gurjarpravin4/Sorting_Mechanism/README.md

# Sorting_Mechanism
Color and Weight Based Package Sorting Mechanism.
This repository includes all the Schematics, PCB Layouts and Code we used to run this project.
It also includes a project report where the details of the project and it's results are discussed.
