gurjarpravin4/Sorting_Mechanism/Documentation/MiniProjectMain.pptx

## Pune Institute of Computer Technology, Pune Dept. of E&TC

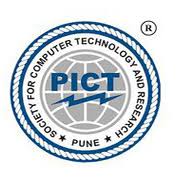
[picture p1: figure]

304200: Mini Project (MP)
(2019 Course)

“Colour and Weight Based
Sorting Model”

Guided By: Prof. Vaibhav Vaijapurkar

By:
1) Omkar Navalgundkar (32128)
2) Prajwal Padwal (32133)
3) Pravin Gurjar (32139)

## Introduction

- Wide use of sorting mechanisms in industries.
  - Recycling plants: They sort materials based on types, size and weight.
  - Manufacturing industries: They sort products based on defects or quality control criteria and ensure good product delivery.
- The proposed project is inspired by these different sorting mechanisms.
- Contribute to industries like toys industries, food and beverages processing industries etc.
- Will feature sorting based on parameters:
  - Colour
  - Weight

TE 5

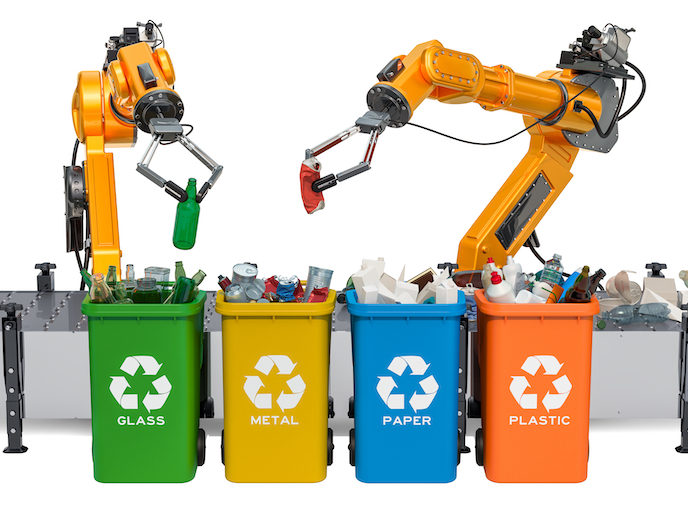
[picture p2: figure]

## Aim and Objectives

Aim:
- To design a sorting mechanism to sort objects based on colour and weight.
Objectives:
1. To study existing sorting techniques.
2. To develop a conveyor belt for the model using various motors.
3. To implement and verify the designed sorting system.

TE 5

## Block Schematic

Sorting Mechanism

Object Detection

Colour Sensor

Power Supply

Motor Driver for flaps

Motor Driver

Flaps

Microcontroller

Conveyor System

DC Motor

Weight Sensor

## Resources Required

1. ATMega 32
2. Permanent Magnet Stepper Motor
3. Conveyor Belt
4. DC motor
5. Colour sensor
6. IR sensor
7. Load cell
8. Soldering Gun and Solder

1. AVR Studio
2. Proteus Design Suite 8.0
3. AutoCAD

- Hardware

- Software

## Slide 6

Simulation Labels

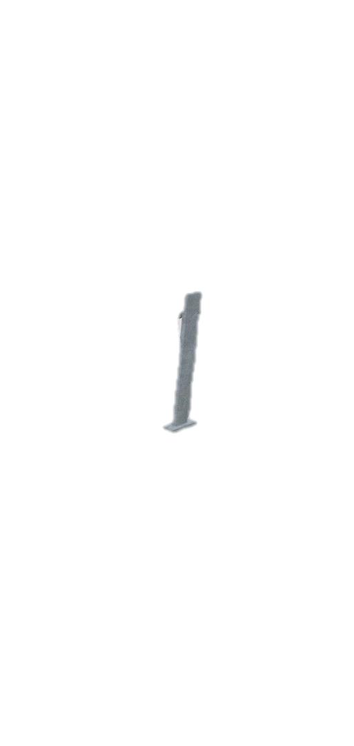
[picture p3: figure]
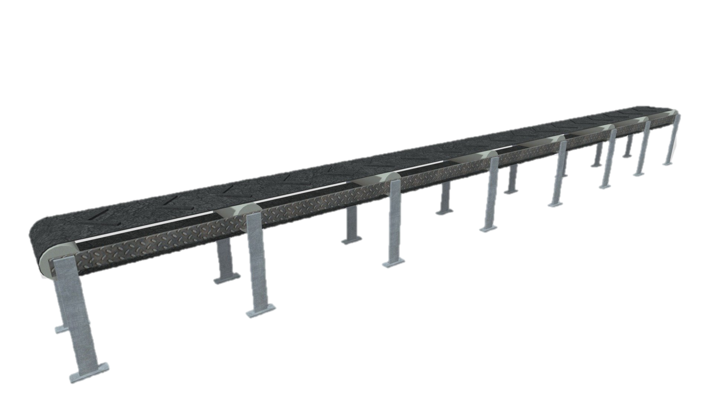
[picture p4: figure]

Flaps

Color sensor

IR sensor

Stepper Motor

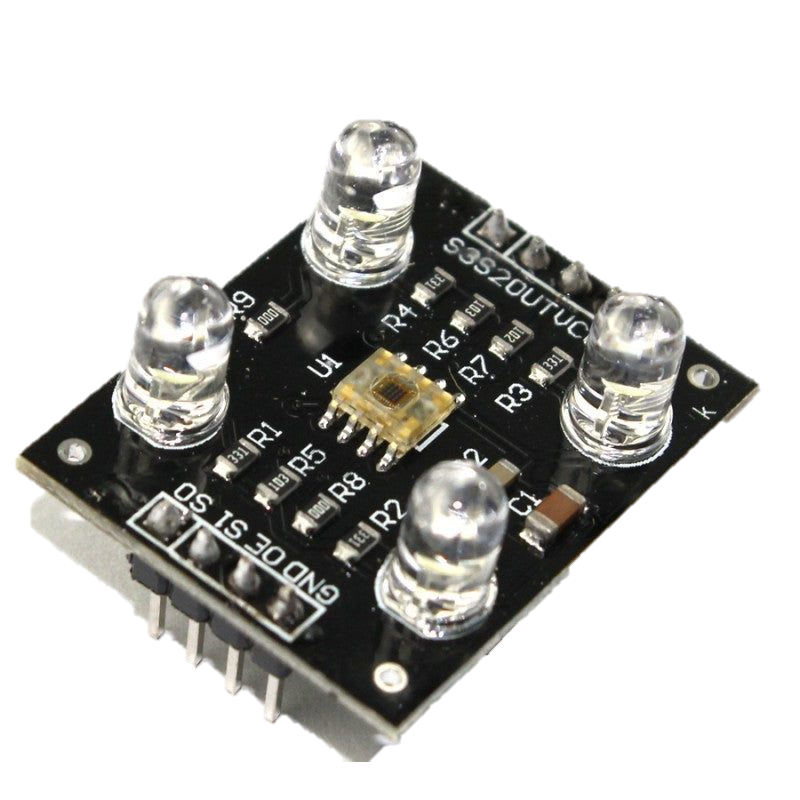
[picture p5: figure]
Buy Color Sensor TCS3200D/TCS230 Online in India | Robocraze
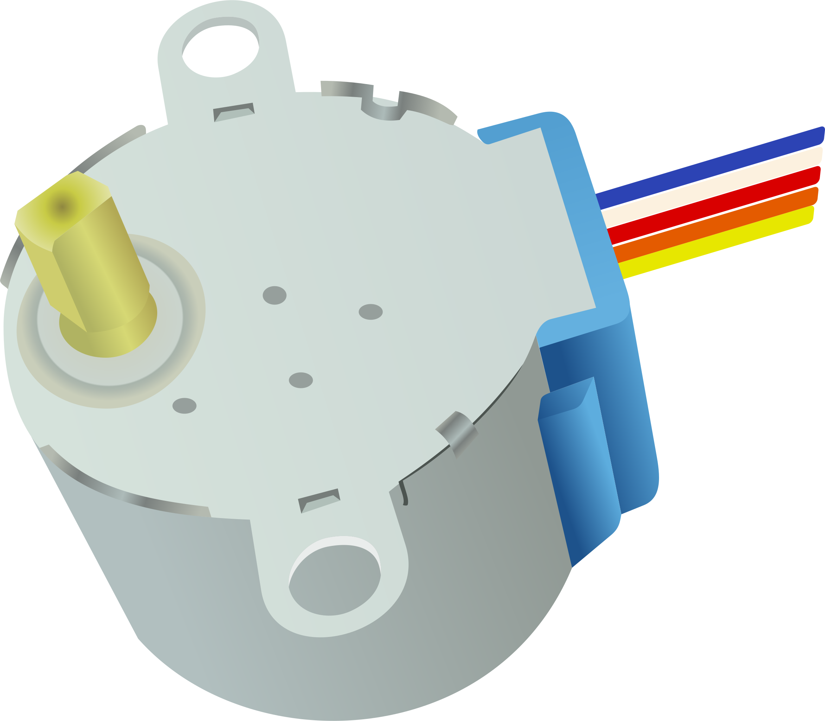
[picture p6: figure]

Load cell

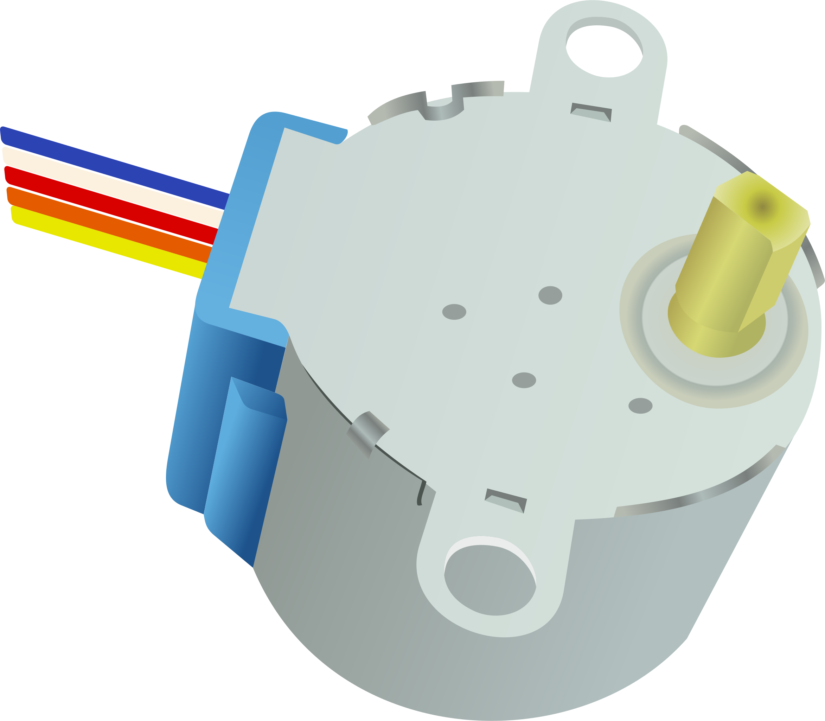
[picture p7: figure]

IR sensor

Atmega 32

## Slide 7

- IR Sensor detects object, conveyor stops
- Colour sensor and load cell decide sorting parameter

Example 1: Heavy Red object

Example 2: Lightweight Green box

Color sensor

IR sensor

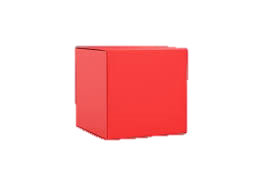
[picture p8: figure]
2,118,590 Red Box Images, Stock Photos & Vectors | Shutterstock

- 2nd IR sensor stops conveyor.
- Jaws attached to rotor move in clockwise direction for angle 120^0

- Colour and weight detection

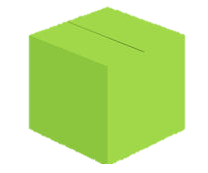
[picture p9: figure]
Cardboard Stock Illustrations – 318,580 Cardboard Stock Illustrations, Vectors & Clipart - Dreamstime

Lightweight green

Lightweight red

Load cell

Heavy green

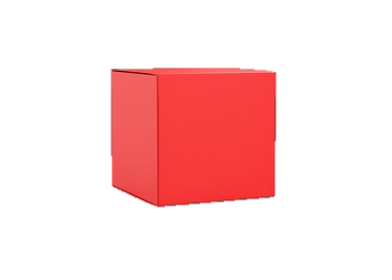
[picture p10: figure]
2,121,253 Red Box Images, Stock Photos & Vectors | Shutterstock
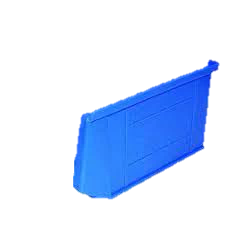
[picture p11: figure]
Storage Bin for spare components, hardware, medicines ,Plastic, 295 mm X 210mm X 160mm, Set of 3 - Breval Consulting Services

Heavy red

Atmega 32

## Features, future Scope

Features:
- A four-way automated sorting mechanism.
- Single belt and multiple object sorting.
Future Scope:
- Size and shape of object may be considered.
- Time required may be reduced and number of objects sorted may be increased.
- Adding flap mechanism to increase ways for sorting.

TE 5

## References

1. S. Huang and S. S. Zhang, "Design and Control of a Conveyor-Based Sorting System," in IEEE Transactions on Automation Science and Engineering, vol. 10, no. 3, pp. 728-736, July 2013, doi: 10.1109/TASE.2012.2236971.
2. N. S. A. Ali, A. R. A. Rahman, A. F. M. Asib and A. F. M. Hidayatullah, "Design and Development of Conveyor Sorting Mechanism for Industrial Applications," in 2018 IEEE Conference on Sustainable Utilization and Development in Engineering and Technology (CSUDET), Kuala Lumpur, Malaysia, 2018, pp. 1-5, doi: 10.1109/CSUDET.2018.8644758.
DATASHEET:
Drivers: https://www.ti.com/lit/ds/symlink/l293d.pdf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
https://www.st.com/resource/en/datasheet/uln2001.pdf

## Slide 10

Thank You!
