gurjarpravin4/Sorting_Mechanism/Schematics/IR_Sensor/LIB_P160KN-0QC15B10K(pot)/P160KN-0QC15B10K/3D/P160KN-0QC15B10K.stp

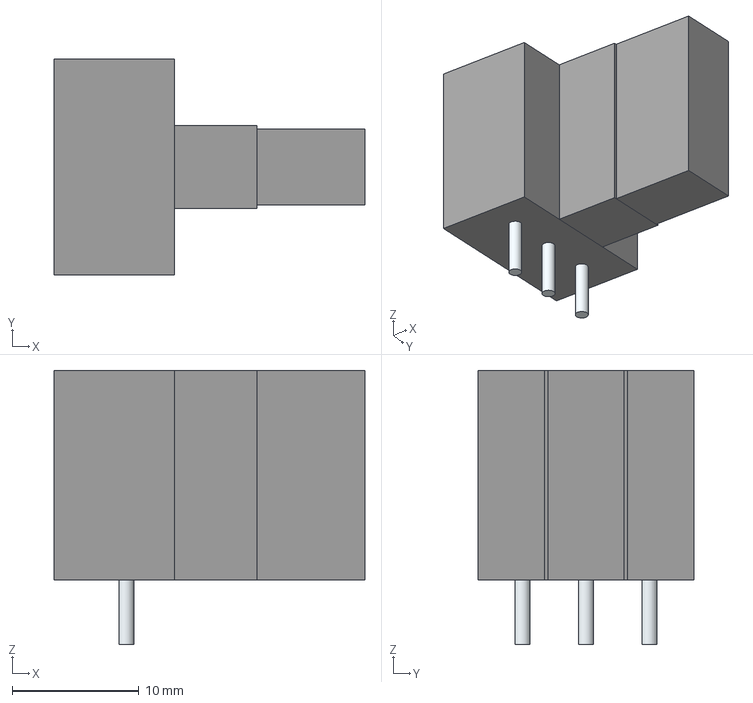
[picture p33: CAD file, 2023-05-28]
Schematics/IR_Sensor/LIB_P160KN-0QC15B10K(pot)/P160KN-0QC15B10K/3D/P160KN-0QC15B10K.stp
24.5 x 17.0 x 21.6 mm
Leads x 3
