gurjarpravin4/Sorting_Mechanism/(list of files, cad)

Other CAD files:
Schematics/IR_Sensor/LIB_P160KN-0QC15B10K(pot)/P160KN-0QC15B10K/Allegro/p160kn0qc15b10k.psm
Schematics/IR_Sensor/LIB_P160KN-0QC15B10K(pot)/P160KN-0QC15B10K/DEHDL/p160kn_0qc15b10k/chips/chips.prt
Schematics/Main_Project/LIB_TCS34725FN/TCS34725FN/Allegro/fn_1.psm
Schematics/Main_Project/LIB_TCS34725FN/TCS34725FN/DEHDL/tcs34725fn/chips/chips.prt
