gurjarpravin4/Sorting_Mechanism/Schematics/IR_Sensor/pcb_layout_ir_sensor.PDF

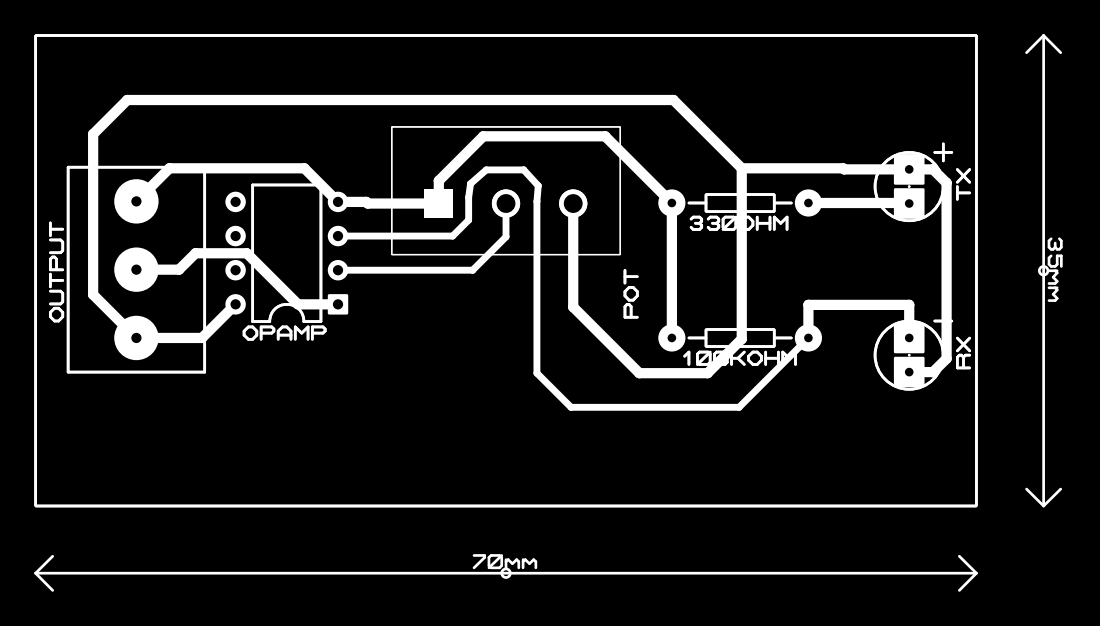
[picture p34: page 1]
