gurjarpravin4/Sorting_Mechanism/Schematics/IR_Sensor/printable_ir_sensor.PDF

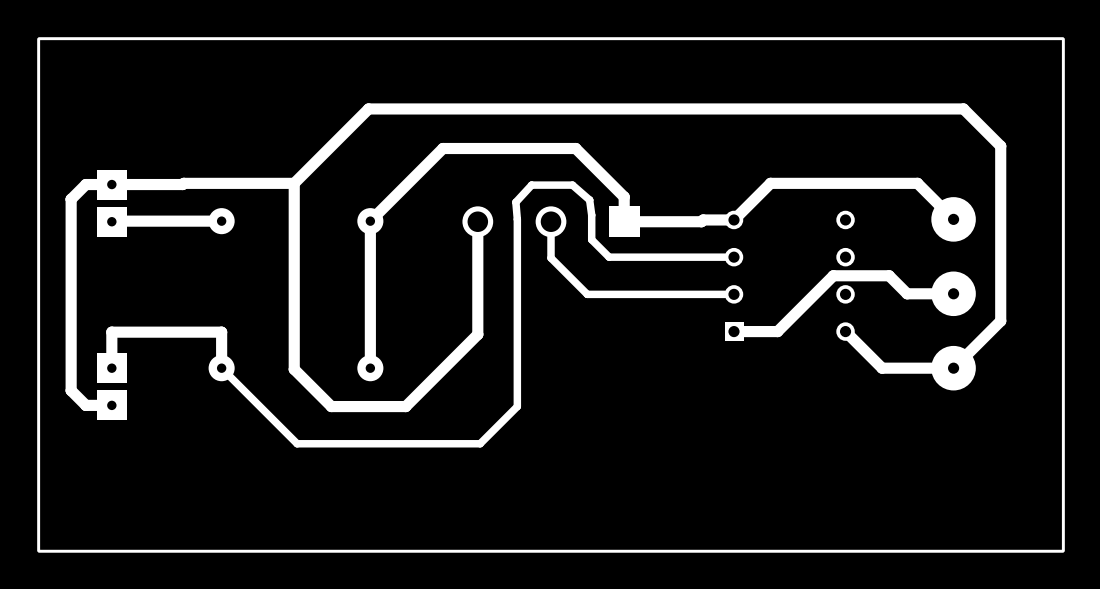
[picture p35: page 1]
