gurjarpravin4/Sorting_Mechanism/Schematics/IR_Sensor/schematic_ir_sensor.PDF

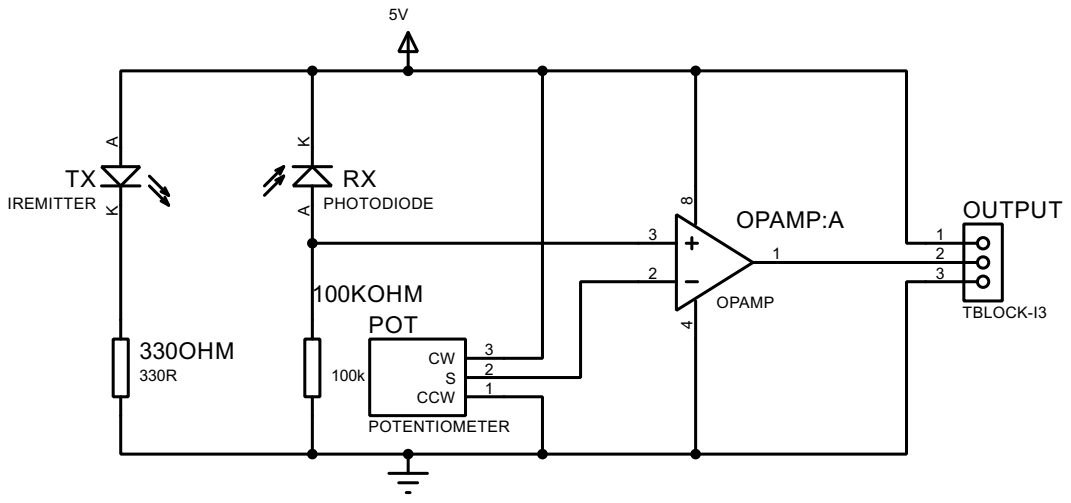
[picture p36: page 1]
