gurjarpravin4/Sorting_Mechanism/Schematics/Main_Project/sorting_mech.pdf

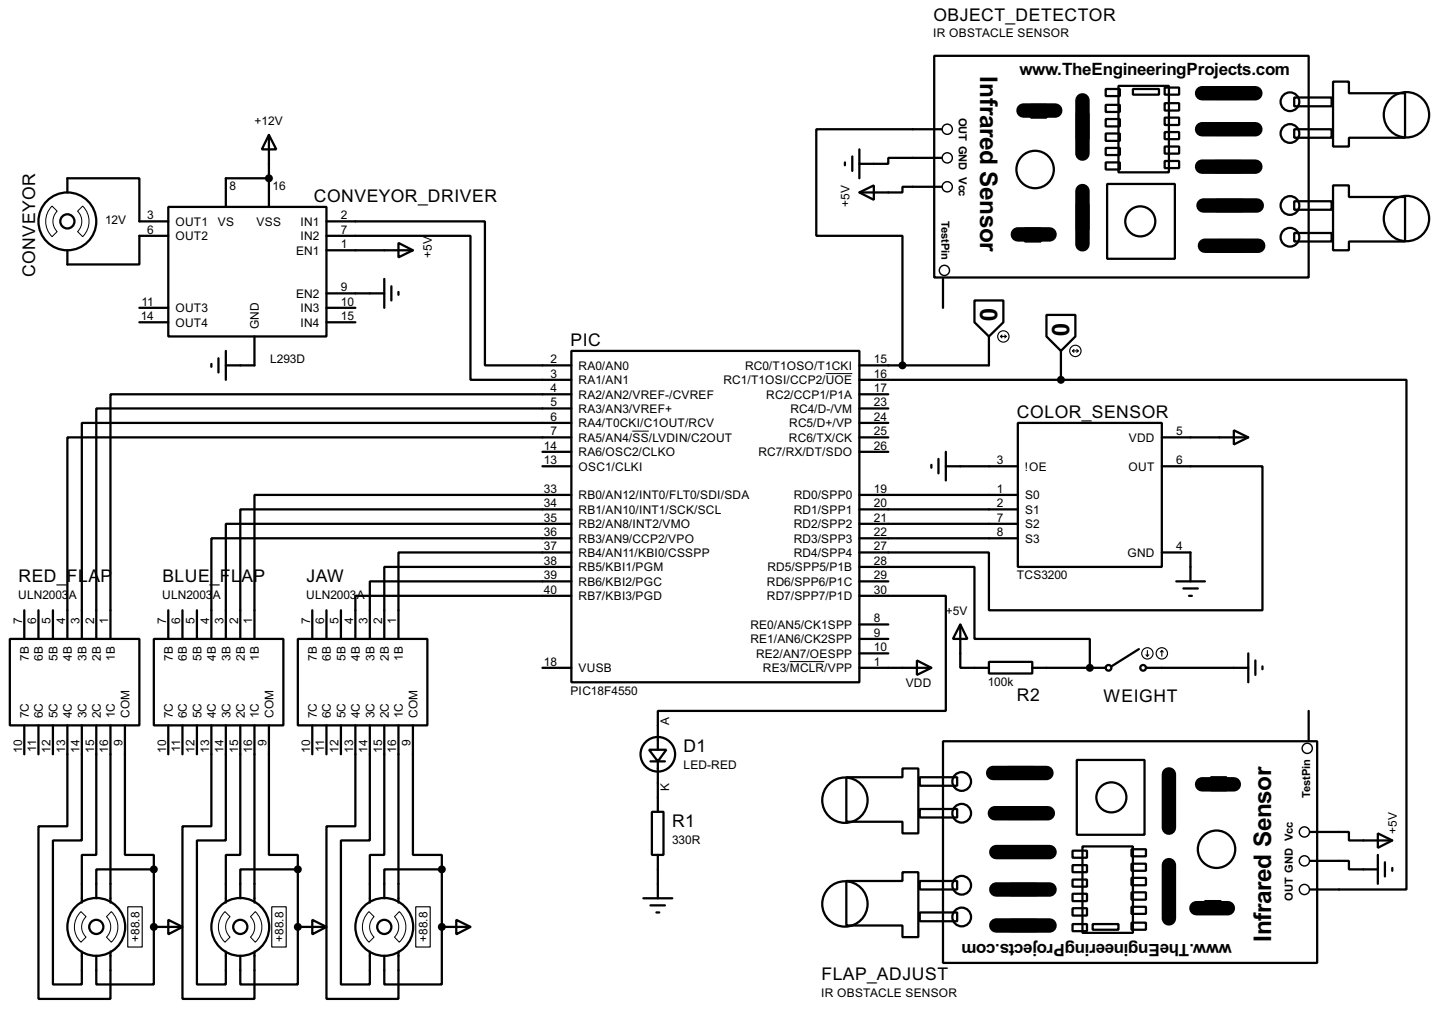
[picture p37: page 1]

28 RD6/SPP6/P1C 29 RD7/SPP7/P1D | TCS3200

30 RE0/AN5/CK1SPP
