gurjarpravin4/Sorting_Mechanism/Schematics/PIC_Board/PIC_Board_Print.pdf

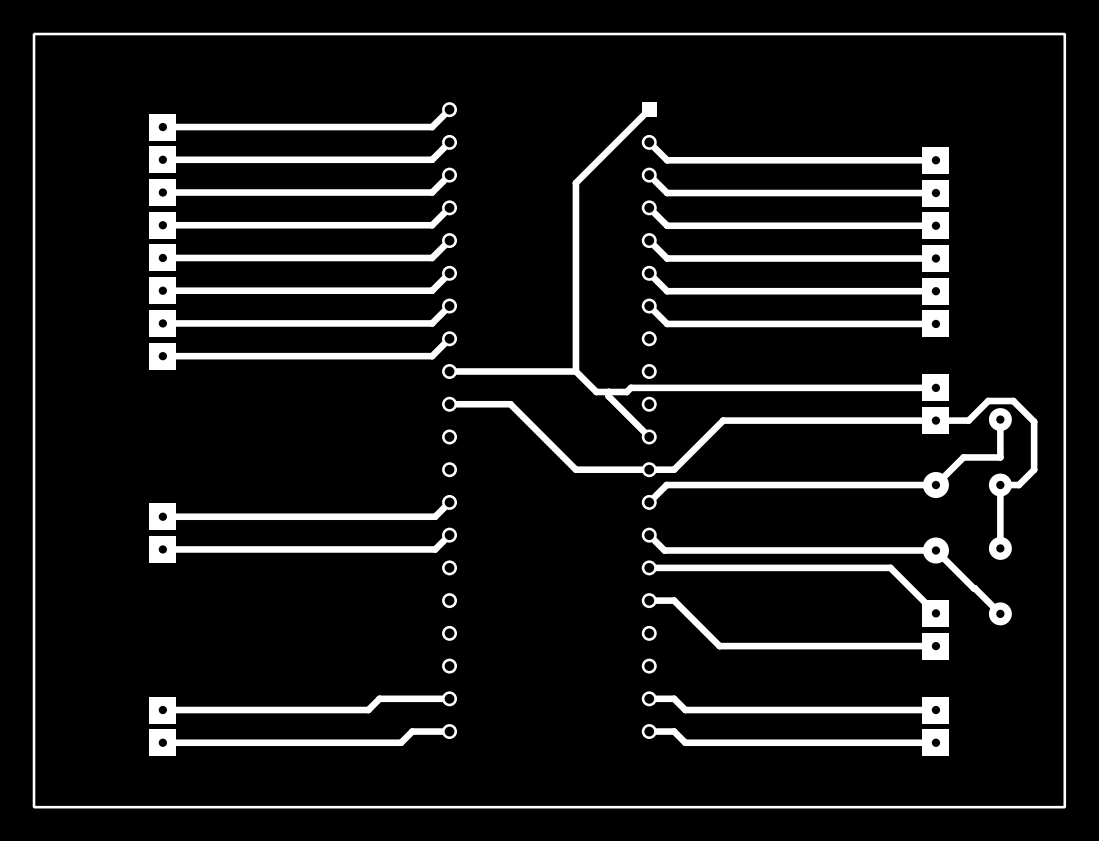
[picture p38: page 1]
