gurjarpravin4/Sorting_Mechanism/Schematics/PIC_Board/PIC_Board_Ref.pdf

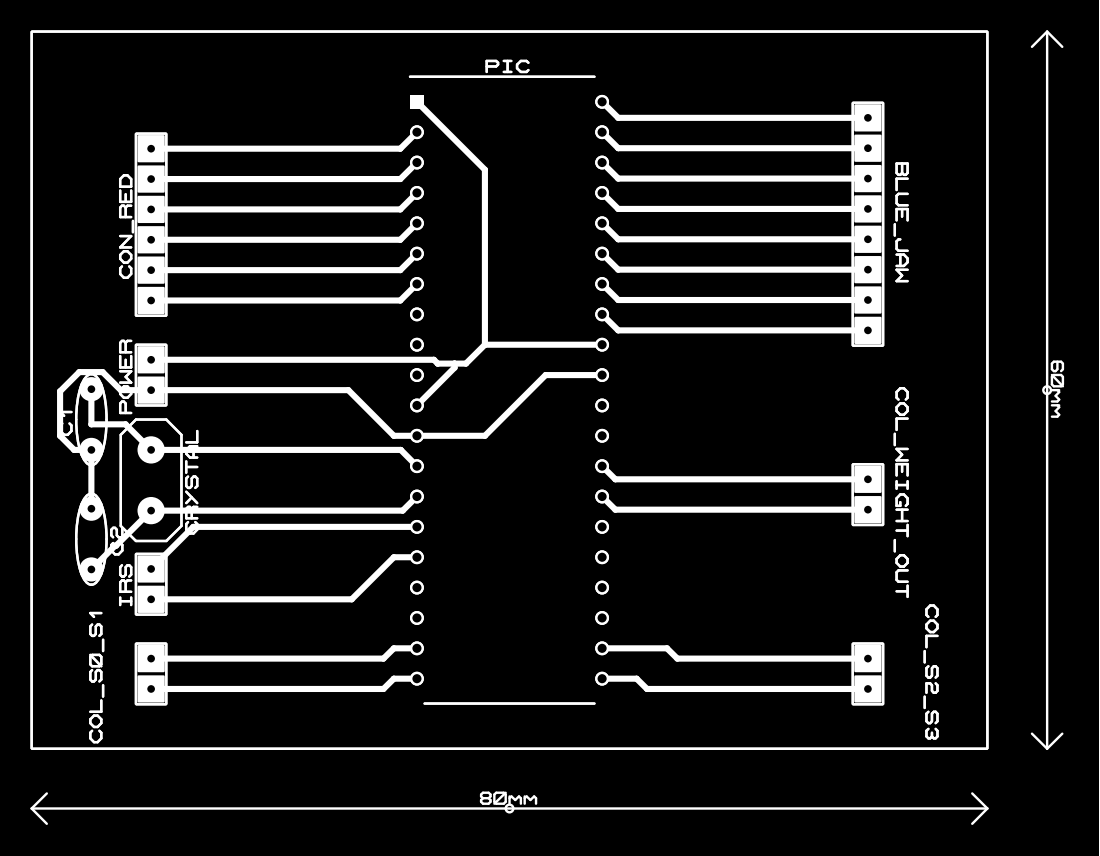
[picture p39: page 1]
