gurjarpravin4/Sorting_Mechanism/Schematics/PIC_Board/PIC_Board_Schematic.PDF

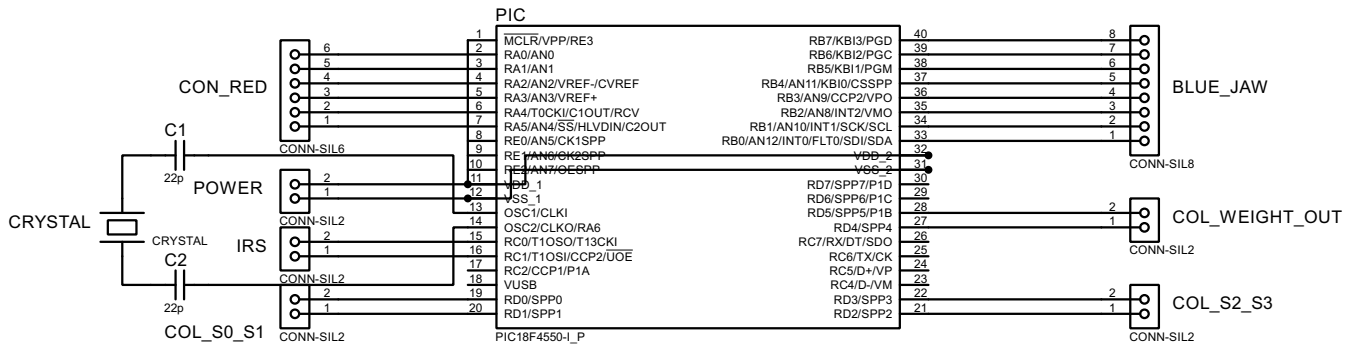
[picture p40: page 1]
