gurjarpravin4/Sorting_Mechanism/Schematics/temp/Sorting_Mechanism.PDF

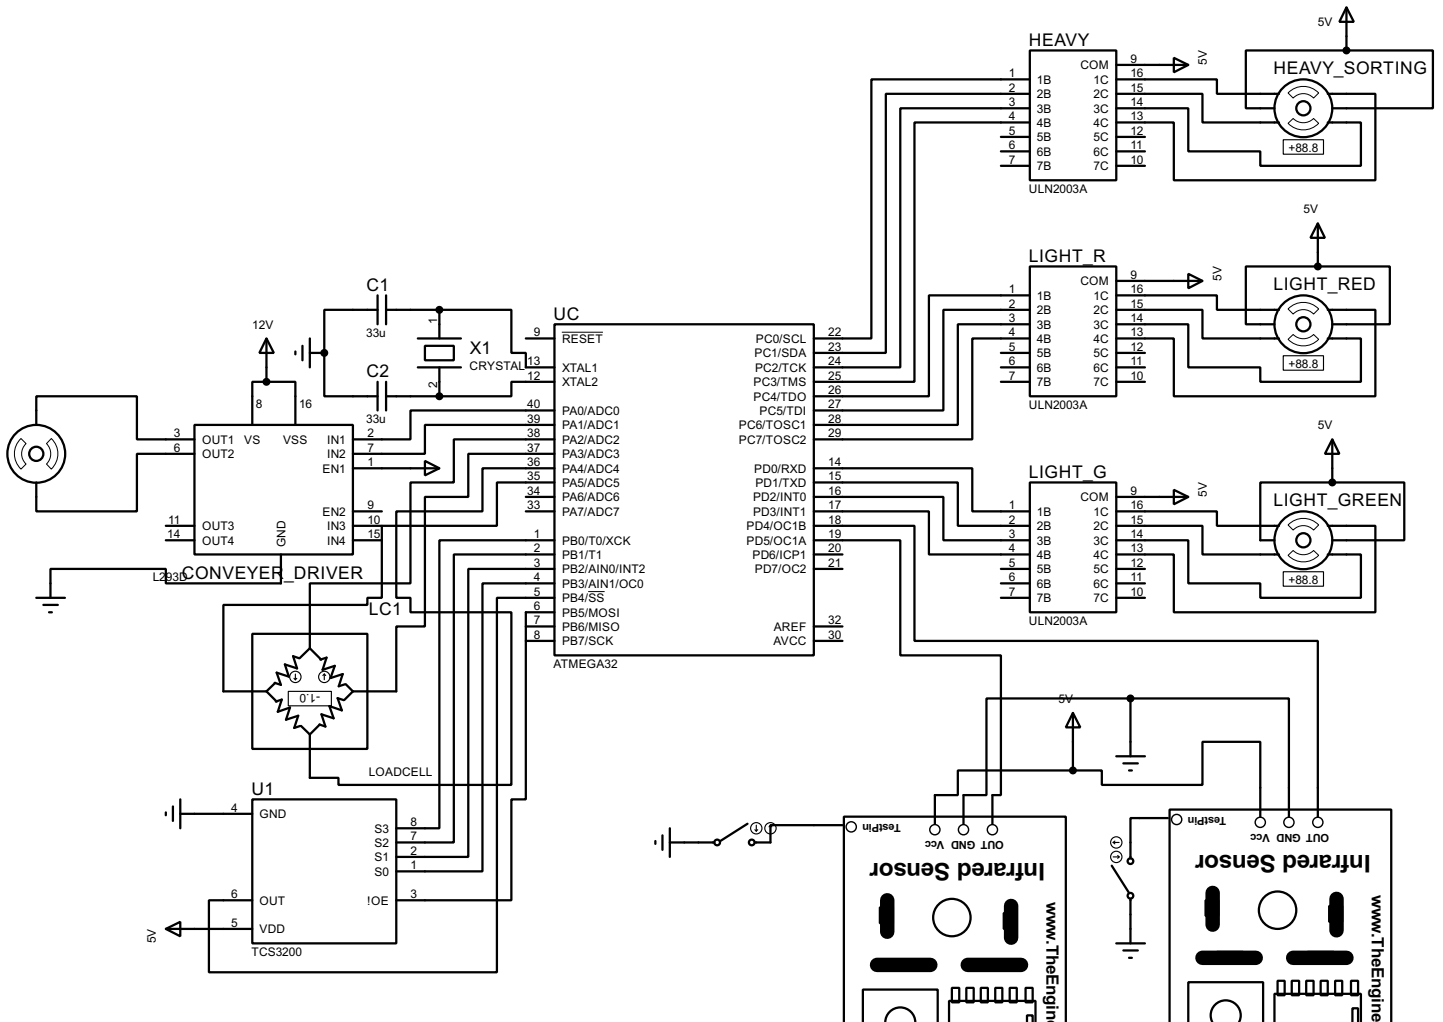
[picture p41: page 1]
