gurjarpravin4/Sorting_Mechanism/(list of files, drawings)

Other design files:
Schematics/IR_Sensor/ir_sensor.pdsprj
Schematics/IR_Sensor/LIB_P160KN-0QC15B10K(pot)/P160KN-0QC15B10K/Altium/P160KN0QC15B10K.PcbLib
Schematics/IR_Sensor/LIB_P160KN-0QC15B10K(pot)/P160KN-0QC15B10K/Altium/P160KN-0QC15B10K.SchLib
Schematics/Main_Project/LIB_TCS34725FN/TCS34725FN/Altium/FN_1.PcbLib
Schematics/Main_Project/LIB_TCS34725FN/TCS34725FN/Altium/TCS34725FN.SchLib
Schematics/Main_Project/sorting_mech.pdsprj
Schematics/PIC_Board/PIC_Board.pdsprj
Schematics/Power_Supply/DualPS.pdsprj
Schematics/Power_Supply/LM317/Power_supply_12v(LM317).pdsprj
Schematics/temp/Sorting_Mechanism.pdsprj
